iviivanchu/techlab-solution/web/contactform/Readme.txt

Fully working PHP/AJAX contact form is available in the pro version.
You can buy it from: https://bootstrapmade.com/remember-free-multipurpose-bootstrap-template/
