iviivanchu/techlab-solution/Box/CAIXA.FCStd

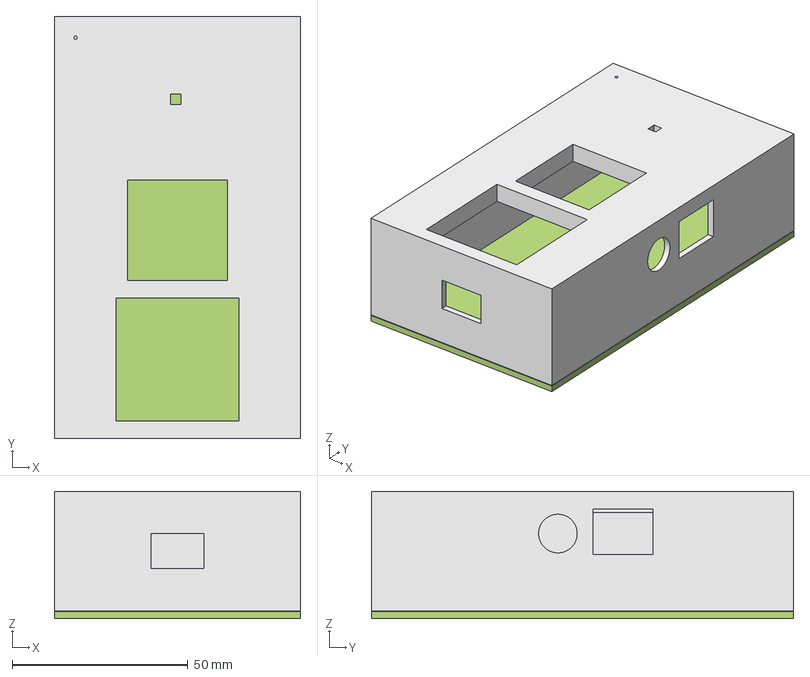
[picture p7: CAD file, 2022-01-31]
Box/CAIXA.FCStd
70.0 x 120.0 x 36.2 mm
