iviivanchu/techlab-solution/PCB/Esquema Placa.pdf

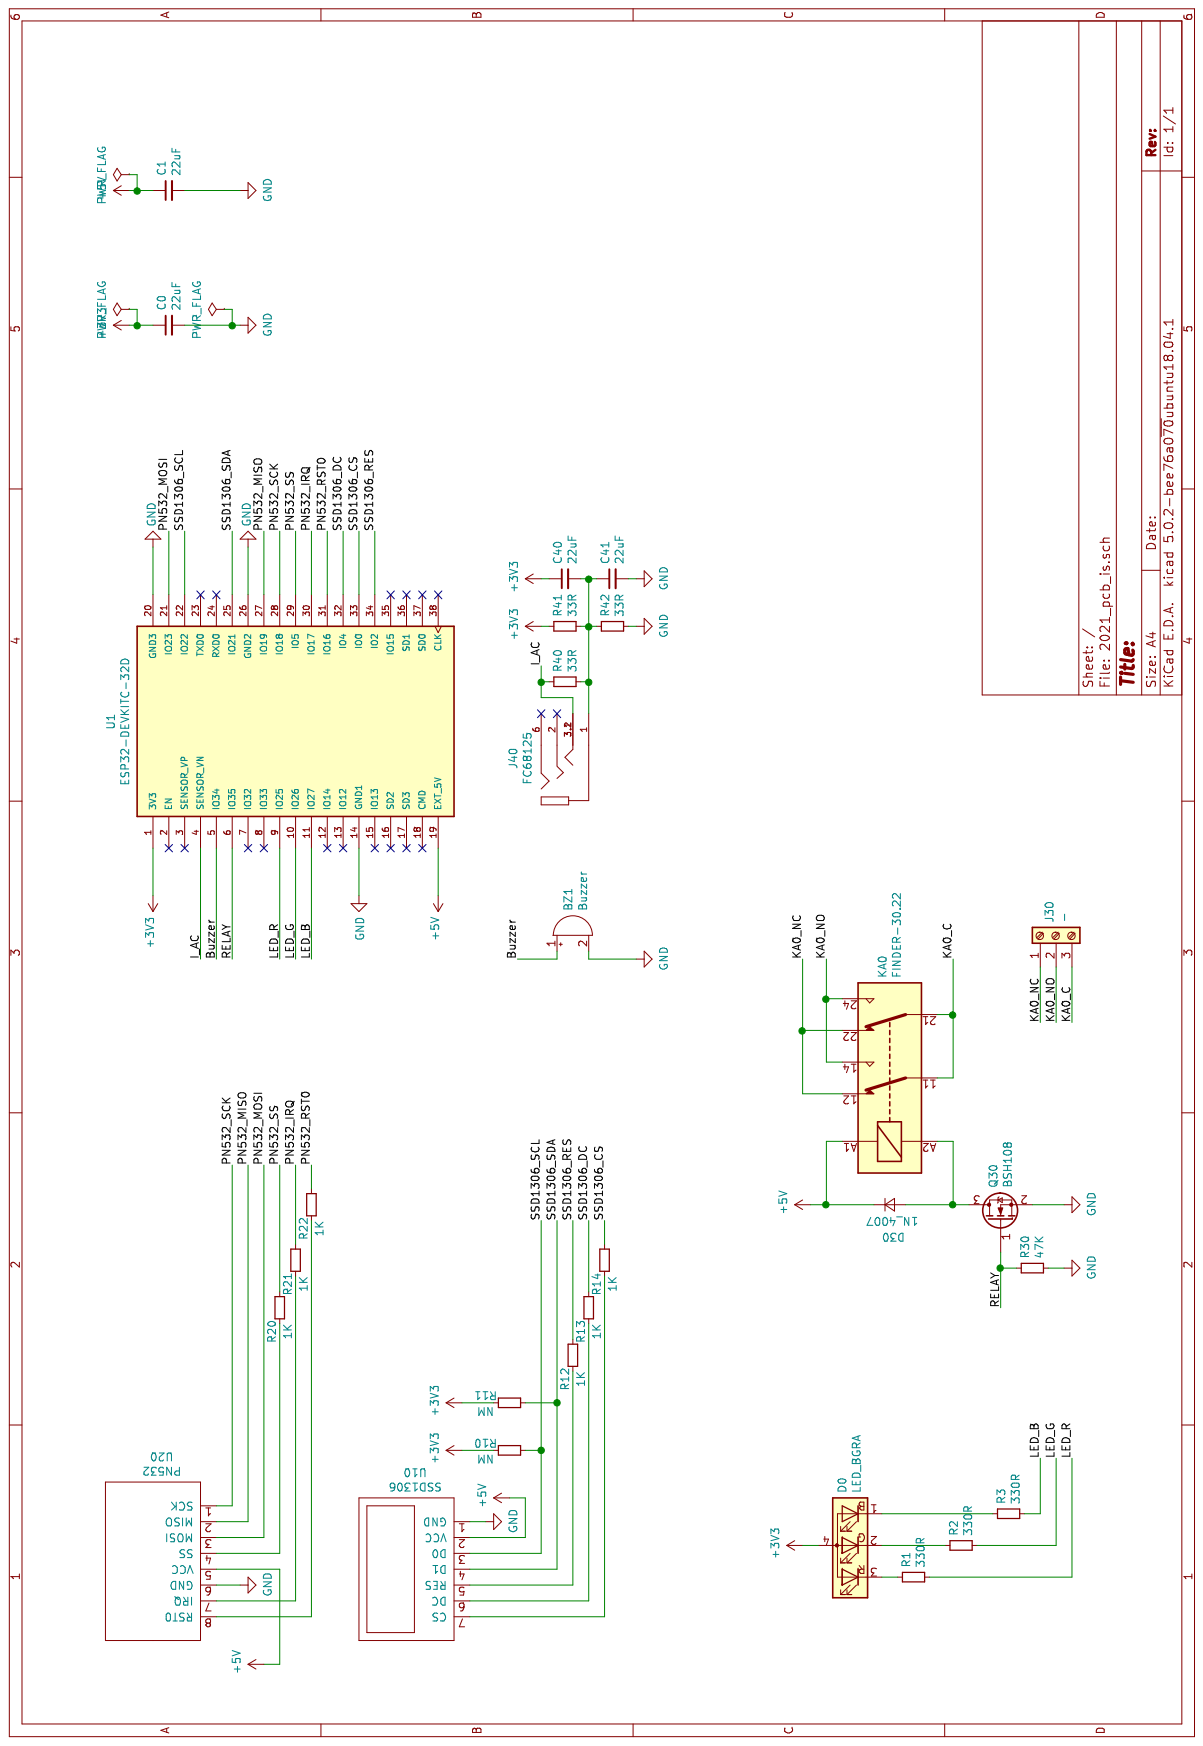
[picture p8: page 1]
