iviivanchu/techlab-solution/PCB/Fitxers KiCad/2021_pcb_is_manufacturing/2021_pcb_is.kicad_pcb

## KiCad design PCB/Fitxers KiCad/2021_pcb_is_manufacturing/2021_pcb_is.kicad_pcb (2022-02-23)

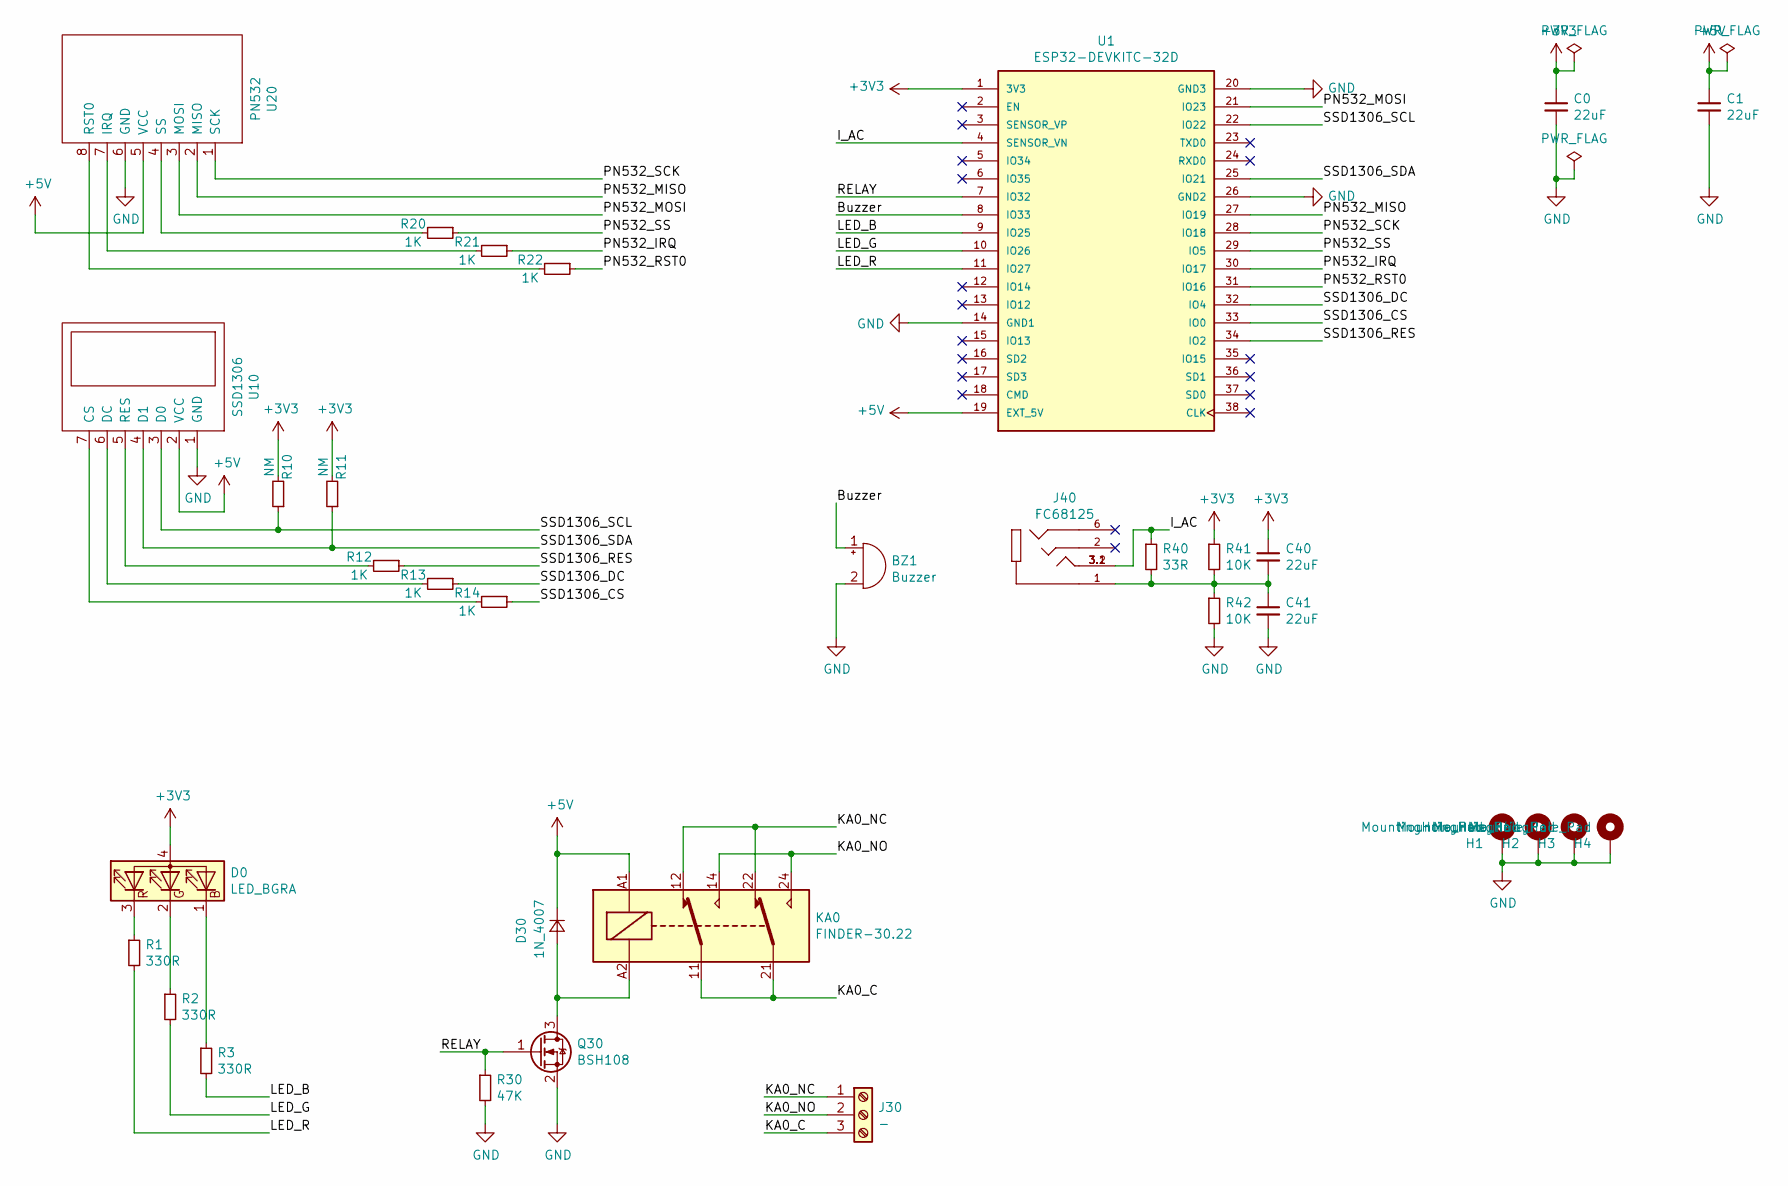
[picture p9: schematic 2021_pcb_is.sch]

Parts:
BZ1: Buzzer; Buzzer_15x7.5RM7.6
C0, C1, C40, C41: 22uF; C_0805_2012Metric_Pad1.15x1.40mm_HandSolder
D0: LED_BGRA; LED_Avago_PLCC4_3.2x2.8mm_CW
D30: 1N_4007; D_DO-41_SOD81_P10.16mm_Horizontal
H1, H2, H3, H4: MountingHole_Pad; MountingHole_3.2mm_M3_ISO14580_Pad
J30: -; TerminalBlock_RND_205-00013_1x03_P5.00mm_Horizontal
J40: FC68125; CLIFF_FC68125
KA0: FINDER-30.22; Relay_DPDT_Finder_30.22
Q30: BSH108; SOT-23
R1, R2, R3: 330R; R_0805_2012Metric_Pad1.15x1.40mm_HandSolder
R10, R11: NM; R_0805_2012Metric_Pad1.15x1.40mm_HandSolder
R12, R13, R14, R20, R21, R22: 1K; R_0805_2012Metric_Pad1.15x1.40mm_HandSolder
R30: 47K; R_0805_2012Metric_Pad1.15x1.40mm_HandSolder
R40: 33R; R_0805_2012Metric_Pad1.15x1.40mm_HandSolder
R41, R42: 10K; R_0805_2012Metric_Pad1.15x1.40mm_HandSolder
U1: ESP32-DEVKITC-32D; MODULE_ESP32-DEVKITC-32D; PARTREV 4
U10: SSD1306; SSD1306_2H
U20: PN532; PN532_N3D_3

Connections:
+3V3: C0.1, C40.1, D0.4 (A), R10.2, R11.2, R41.1, U1.1 (3V3)
+5V: C1.1, D30.1 (K), KA0.A1, U1.19 (EXT_5V), U10.2 (VCC), U20.5 (VCC)
/Buzzer: BZ1.1 (-), U1.8 (IO33)
/I_AC: J40.3.1 (3T), J40.3.2 (3T), R40.1, U1.4 (SENSOR_VN)
/KA0_C: J30.3, KA0.11, KA0.21
/KA0_NC: J30.1, KA0.12, KA0.22
/KA0_NO: J30.2, KA0.14, KA0.24
/LED_B: R3.2, U1.9 (IO25)
/LED_G: R2.2, U1.10 (IO26)
/LED_R: R1.2, U1.11 (IO27)
/PN532_IRQ: R21.1, U1.30 (IO17)
/PN532_MISO: U1.27 (IO19), U20.2 (MISO)
/PN532_MOSI: U1.21 (IO23), U20.3 (MOSI)
/PN532_RST0: R22.1, U1.31 (IO16)
/PN532_SCK: U1.28 (IO18), U20.1 (SCK)
/PN532_SS: R20.1, U1.29 (IO5)
/RELAY: Q30.1 (G), R30.1, U1.7 (IO32)
/SSD1306_CS: R14.1, U1.33 (IO0)
/SSD1306_DC: R13.1, U1.32 (IO4)
/SSD1306_RES: R12.1, U1.34 (IO2)
/SSD1306_SCL: R10.1, U1.22 (IO22), U10.3 (D0)
/SSD1306_SDA: R11.1, U1.25 (IO21), U10.4 (D1)
GND: BZ1.2 (+), C0.2, C1.2, C41.2, H1.1, H2.1, H3.1, H4.1, Q30.2 (S), R30.2, R42.2, U1.14 (GND1), U1.20 (GND3), U1.26 (GND2), U10.1 (GND), U20.6 (GND)
unnamed: C40.2, C41.1, J40.1 (1S), R40.2, R41.2, R42.1
unnamed: D0.1 (BK), R3.1
unnamed: D0.2 (GK), R2.1
unnamed: D0.3 (RK), R1.1
unnamed: D30.2 (A), KA0.A2, Q30.3 (D)
unnamed: R12.2, U10.5 (RES)
unnamed: R13.2, U10.6 (DC)
unnamed: R14.2, U10.7 (CS)
unnamed: R20.2, U20.4 (SS)
unnamed: R21.2, U20.7 (IRQ)
unnamed: R22.2, U20.8 (RST0)

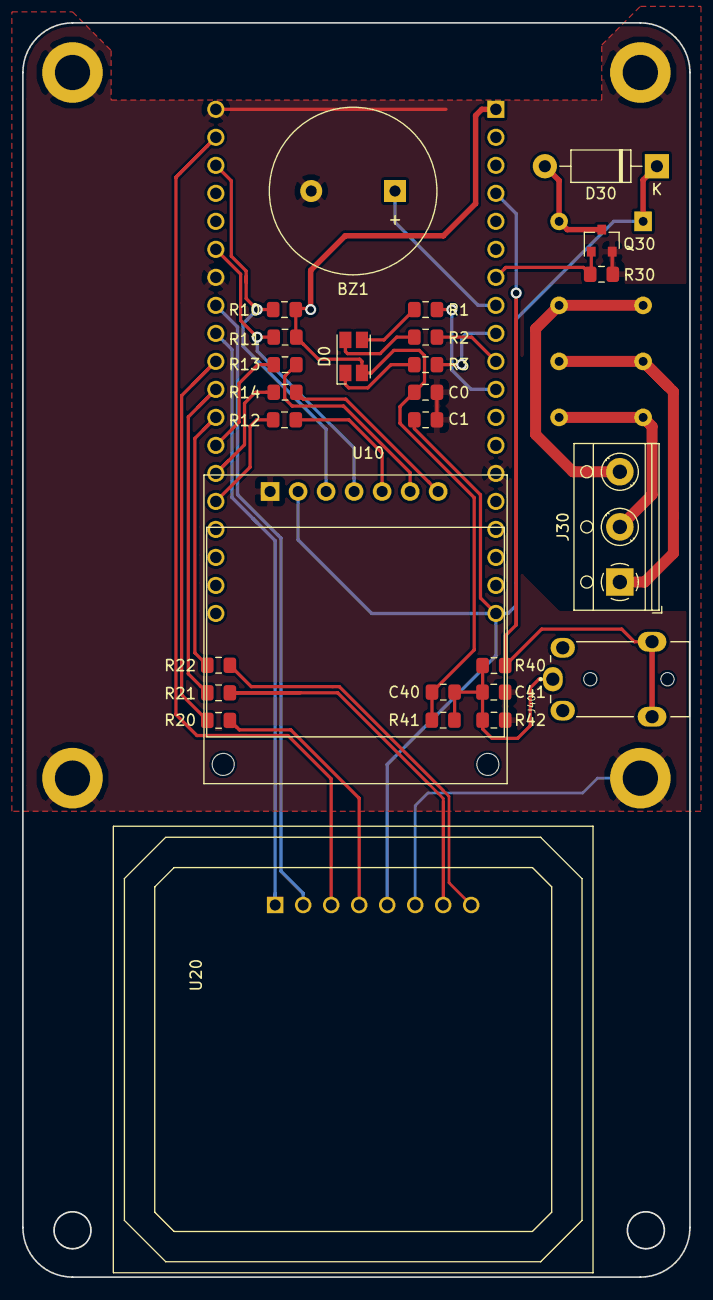
[picture p10: board 2021_pcb_is.kicad_pcb from above]

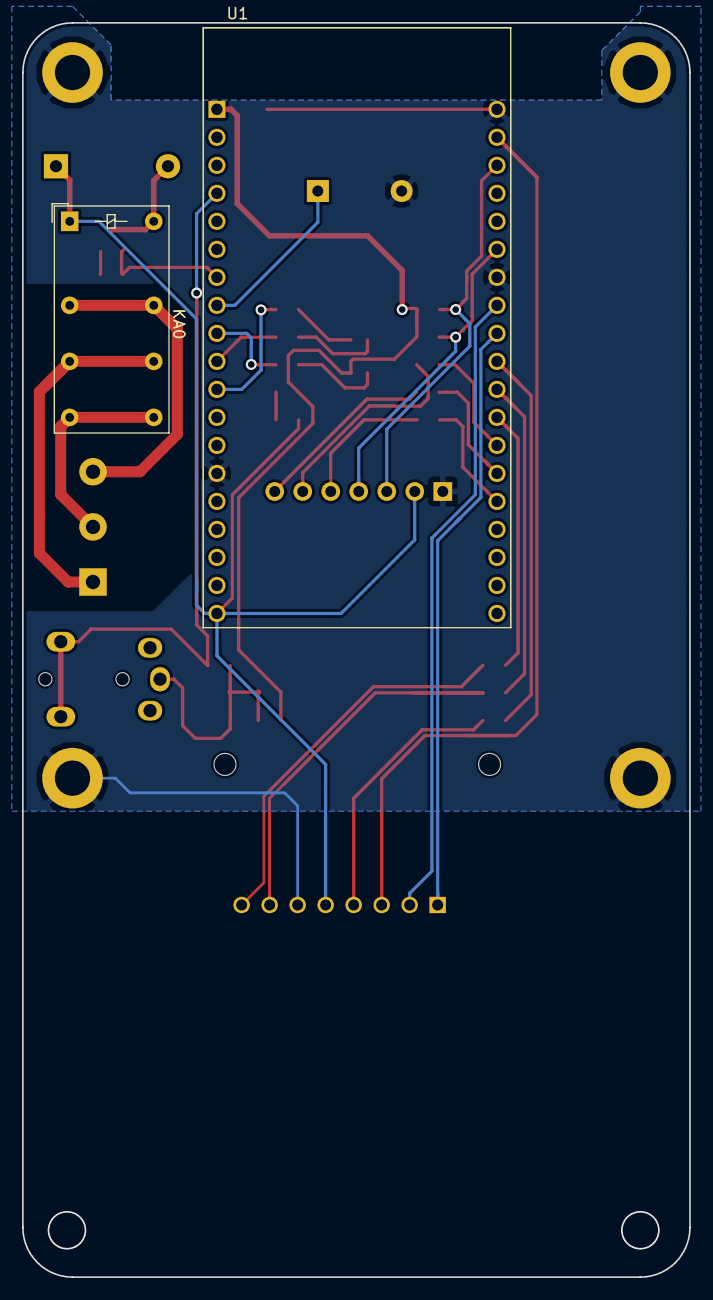
[picture p11: board 2021_pcb_is.kicad_pcb from below]

Board: 2 copper layers, 60.5 x 113.8 mm, 33 parts (2 on the bottom side), 34 nets.
