iviivanchu/techlab-solution/(commit log)

2022-01-31 Add files via upload
    Proyecto subido.
    [CAIXA.FCStd]
2022-02-23 Resubiendo todo
    [CAIXA.FCStd]
2022-02-23 New project updated
    [2021_pcb_is.csv, 2021_pcb_is.kicad_pcb, 2021_pcb_is.sch, CAIXA.FCStd]
